BadgePiratesLLC/Project_Prospect/README.md

# Project_Prospect

Prospect Board for 2022
