BadgePiratesLLC/Project_Prospect/(commit log)

2021-12-30 Gerbers
    Gerbers for Order
    [ProspectBoards-B_Cu.gbr, ProspectBoards-B_Mask.gbr, ProspectBoards-B_Paste.gbr, ProspectBoards-B_Silkscreen.gbr, ProspectBoards-Edge_Cuts.gbr, ProspectBoards-F_Cu.gbr, ProspectBoards-F_Mask.gbr, ProspectBoards-F_Paste.gbr]
2022-01-30 New Folder structure
    moving files to folders for cleanup
    [ProspectBoards.csv, ProspectBoards.kicad_pcb, ProspectBoards.sch]
2022-02-09 upgrade to 6.01
    [ProspectBoards.kicad_sch]
2022-03-02 Created v2
    Added OTA support
    Added NoDelay library use to support non-blocking actions
    More work on capacitive touch
2022-03-12 Update
    Changed LED feature
    Updated webserial.h library to webroot uri
2022-03-12 Footprint Fixes
    FootPrint fix for the Stupid Ass Button that suxs
    [ProspectBoards.kicad_pcb, ProspectBoards.kicad_sch]
2022-03-12 Moved Cap Button
    Moved the CAP buttons further apart to help with sensing
    [ProspectBoards.kicad_pcb]
2022-03-12 Added DNS Resolver to point to badge IP
    [BP_Prospect_Badge_Demo_Code.ino]
2022-03-15 Fixed WebSerial Text Scroll
    [BP_Prospect_Badge_Demo_Code.ino]
